rheingoldheavy/MSGEQ7-Breakout-Board/MSGEQ7_Breakout_Board/MSGEQ7_Breakout_Board_BOM.xlsx

Sheet: MSGEQ7 Breakout Board BOM
Index | Module | Item | Item Type | Distributor | Manufacturer | Manuf Part # | Distributor Part # | 1x Price | 10x Price | 25x Price | 100x Price | Datasheet | Manuf. Footprint | KiCAD Footprint | Size / Pinout
1 | Breakout Board | Bypass Capacitor 0.1uF | Capacitor | Digi-Key | Murata | RDER71H104K0M1H03A | 490-9144-1-ND | $0.2800 | $0.2360 | $0.2360 | $0.1180 | Link (http://media.digikey.com/pdf/Data%20Sheets/Murata%20PDFs/RDE%20Series.pdf) | PTH 5.0mm Spacing | C2 | x / x
2 | Breakout Board | Load Capacitor 33pF | Capacitor | Digi-Key | Vishay | K330J15C0GF5TL2 | BC1007CT-ND | $0.3400 | $0.2520 | $0.2520 | $0.1176 | Link (http://datasheet.octopart.com/K330J15C0GF5TL2-Vishay-datasheet-13562638.pdf) | PTH 2.5mm Spacing | C1 | x / x
3 | Breakout Board | Timing Resistor 200K | Resistor | Digi-Key | Stackpole Electronics | CF14JT200K | CF14JT200KCT-ND | $0.1000 | $0.0530 | $0.0530 | $0.0219 | Link (https://www.seielect.com/catalog/SEI-CF_CFM.pdf) | PTH 6mm body / .55mm lead dia. | PTH_RESISTOR | x / x
4 | Breakout Board | Input Resistor 22K | Resistor | Digi-Key | Stackpole Electronics | CF14JT22K0 | CF14JT22K0CT-ND | $0.1000 | $0.0530 | $0.0530 | $0.0219 | Link (https://www.seielect.com/catalog/SEI-CF_CFM.pdf) | PTH 6mm body / .55mm lead dia. | PTH_RESISTOR | x / x
5 | Breakout Board | MSGEQ7 | Main IC | Mixed Signal Integration | Mixed Signal Integration | MSGEQ7P | MSGEQ7P | $3.9600 | $3.9600 | $3.9600 | $3.9600 | Link (http://www.mix-sig.com/index.php/msgeq7-seven-band-graphic-equalizer-display-filter) | DIP-8 | DIP-8_300 | x / x
6 | Breakout Board | Mechanical | 6 Pin Header | Digi-Key | Sullins Connector | PREC005SAAN-RC | S1012EC-05-ND | $0.1600 | $0.1460 | $0.1460 | $0.1202 | Link (http://media.digikey.com/PDF/Data%20Sheets/Sullins%20PDFs/z%20RzCzzzSzzN-RC,%20ST,11635-B.pdf) | 0.1" Spaced Header | PIN_ARRAY_5x1 | x / x
7 | Breakout Board | Audio In Jack | Stereo Mini Jack | Digi-Key | CUI Inc | SJ1-3523NG | CP1-3523NG-ND | $1.0400 | $0.8080 | $0.8080 | $0.6165 | Link (http://www.cui.com/product/resource/sj1-352xng-series.pdf) | 3-pin Custom | Custom | x / x
8 | Breakout Board | PCB Fabrication | PCB | OSH Park | OSH Park | N/A | N/A | $2.9300 | $2.9300 | $2.9300 | $1.2900

Sheet: Order Work Sheet
Index | Module | Item | Item Type | Distributor | Manufacturer | Manuf Part # | Qty / Assy | Assy | Ttl Min Qty | Order Qty | Distributor Part # | 1x Price | 10x Price | 25x Price | 100x Price | Order Price
1 | Breakout Board | Bypass Capacitor 0.1uF | Capacitor | Digi-Key | Murata | RDER71H104K0M1H03A | 3 | 1 | 3 | 3 | 490-9144-1-ND | $0.2800 | $0.2360 | $0.2360 | $0.1180 | $0.8400
2 | Breakout Board | Load Capacitor 33pF | Capacitor | Digi-Key | Vishay | K330J15C0GF5TL2 | 1 | 1 | 1 | 1 | BC1007CT-ND | $0.3400 | $0.2520 | $0.2520 | $0.1176 | $0.3400
3 | Breakout Board | Timing Resistor 200K | Resistor | Digi-Key | Stackpole Electronics | CF14JT200K | 1 | 1 | 1 | 1 | CF14JT200KCT-ND | $0.1000 | $0.0530 | $0.0530 | $0.0219 | $0.1000
4 | Breakout Board | Input Resistor 22K | Resistor | Digi-Key | Stackpole Electronics | CF14JT22K0 | 2 | 1 | 2 | 2 | CF14JT22K0CT-ND | $0.1000 | $0.0530 | $0.0530 | $0.0219 | $0.2000
5 | Breakout Board | MSGEQ7 | Main IC | Mixed Signal Integration | Mixed Signal Integration | MSGEQ7P | 1 | 1 | 1 | 1 | MSGEQ7P | $3.9600 | $3.9600 | $3.9600 | $3.9600 | $3.9600
6 | Breakout Board | Mechanical | 6 Pin Header | Digi-Key | Sullins Connector | PREC006SAAN-RC | 1 | 1 | 1 | 1 | S1012EC-06-ND | $0.1800 | $0.1570 | $0.1570 | $0.1296 | $0.1800
7 | Breakout Board | Audio In Jack | Stereo Mini Jack | Digi-Key | CUI Inc | SJ1-3523NG | 1 | 1 | 1 | 1 | CP1-3523NG-ND | $1.0400 | $0.8080 | $0.8080 | $0.6165 | $1.0400
 |  |  |  |  |  |  |  |  |  |  |  |  |  |  | Total Parts Cost: | $6.66
 |  |  |  |  |  |  |  |  |  |  |  |  |  |  | Parts Cost Per Board: | $6.66
