rheingoldheavy/MSGEQ7-Breakout-Board/MSGEQ7_Breakout_Board/MSGEQ7_Breakout_Board.pdf

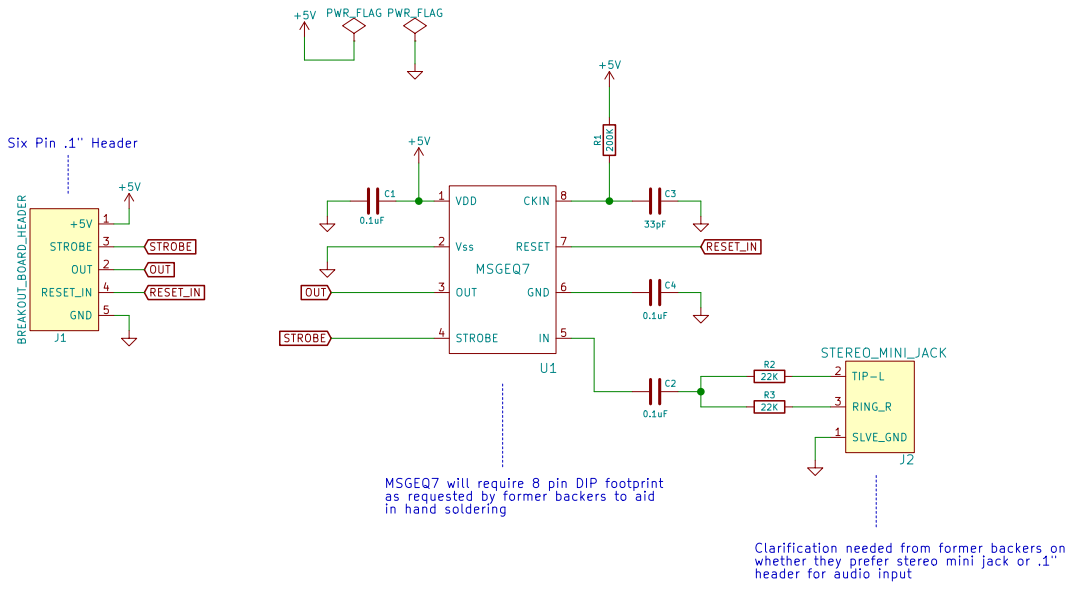
[picture p1: page 1]

MSGEQ7 will require 8 pin DIP footprint
as requested by former backers to aid
in hand soldering

Clarification needed from former backers on
whether they prefer stereo mini jack or .1"
header for audio input

Update to KiCad v4.0.0_RC1
Breakout board for the Mixed Signals Integration MSGEQ7
File: MSGEQ7_Breakout_Board.sch Sheet: / Rheingold Heavy

Id: 1/1 Title: MSGEQ7 Breakout Board
