rheingoldheavy/MSGEQ7-Breakout-Board/MSGEQ7_Breakout_Board/MSGEQ7_Breakout_Board.kicad_pcb

## KiCad design MSGEQ7_Breakout_Board/MSGEQ7_Breakout_Board.kicad_pcb (2015-10-28)

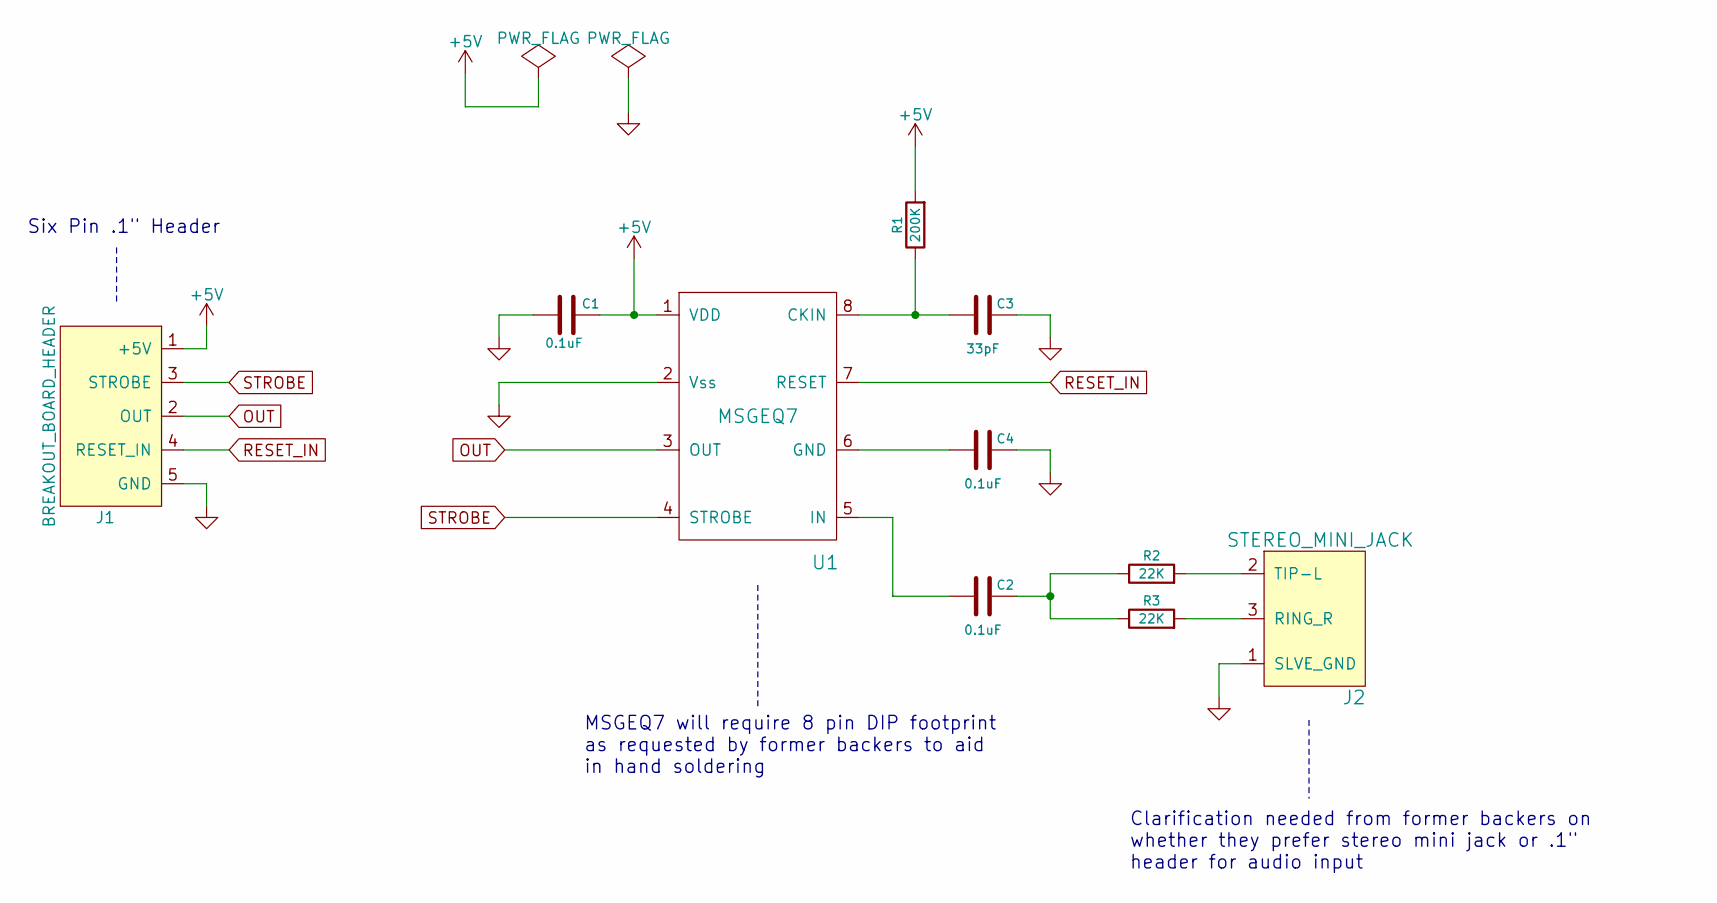
[picture p2: schematic MSGEQ7_Breakout_Board.sch, MSGEQ7 Breakout Board]

Parts:
C1, C2, C4: 0.1uF; C_Disc_D6_P5
C3: 33pF; C_Disc_D3_P2.5
J1: BREAKOUT_BOARD_HEADER; Pin_Header_Straight_1x05
J2: STEREO_MINI_JACK; 3.5mm_Stereo_Jack_SJ1-3523NG; MFG Part Num SJ1-3523NG
R1: 200K; PTH_Resistor
R2, R3: 22K; PTH_Resistor
U1: MSGEQ7; DIP-8_W7.62mm_LongPads

Connections:
+5V: C1.2, J1.1 (+5V), R1.2, U1.1 (VDD)
GND: C1.1, C3.2, C4.2, J1.5 (GND), J2.1 (SLVE_GND), U1.2 (Vss)
unnamed: C2.1, R2.1, R3.1
unnamed: C2.2, U1.5 (IN)
unnamed: C3.1, R1.1, U1.8 (CKIN)
unnamed: C4.1, U1.6 (GND)
unnamed: J2.2 (TIP-L), R2.2
unnamed: J2.3 (RING_R), R3.2
OUT: J1.2 (OUT), U1.3 (OUT)
RESET_IN: J1.4 (RESET_IN), U1.7 (RESET)
STROBE: J1.3 (STROBE), U1.4 (STROBE)

Notes on the sheet:
Six Pin .1" Header
MSGEQ7 will require 8 pin DIP footprint as requested by former backers to aid in hand soldering
Clarification needed from former backers on whether they prefer stereo mini jack or .1" header for audio input

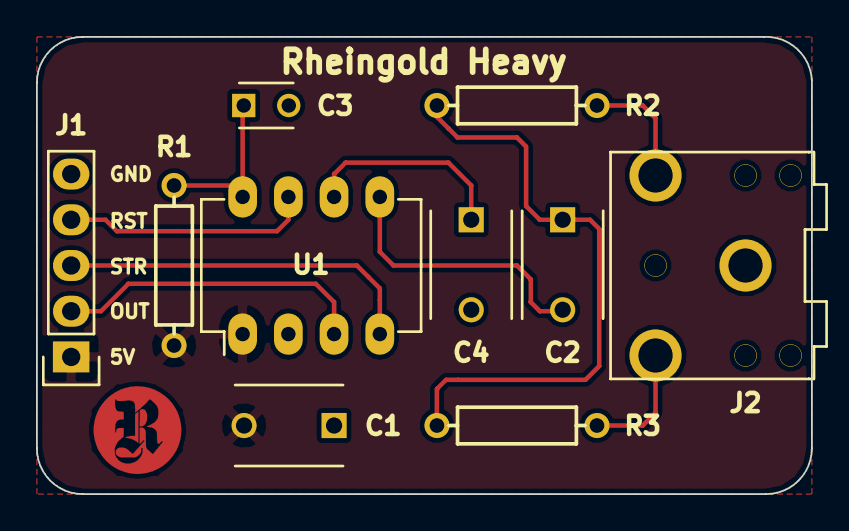
[picture p3: board MSGEQ7_Breakout_Board.kicad_pcb from above]

Board: 2 copper layers, 43.1 x 25.4 mm, 13 parts (0 on the bottom side), 11 nets.

Other parts of the board:
VAL: REF; Logo_RH_Circle_R__F.Cu_.2in
VAL#2: REF; Logo_RH_Circle_R__F.Mask_.2in
VAL#3: REF; Logo_RH_Circle_R_B.SilkS_.750in_flipped
