rheingoldheavy/MSGEQ7-Breakout-Board/(commit log)

2014-11-08 First Draft of Schematic
    First draft of the MSGEQ7 Breakout Board Schematic, based on the
    "Typical Application" drawing on page 4 of the Mixed Signal Integration
    MSGEQ7 Datasheet.
    http://www.mix-sig.com/images/datasheets/MSGEQ7.pdf
    [MSGEQ7_Breakout_Board.sch]
2014-11-15 Refined Schematic and BOM
    Refined the schematic to include new connectors and added the first
    draft of a BOM based on Octopart search.
    [MSGEQ7_Breakout_Board_BOM.xlsx]
2015-01-06 Prototype Layout Completed
    Submitted schematic to Mixed Signal Integration and had it validated for
    correctness. Finalized BOM for the prototype and completed layout with
    an eye towards producing as a kit: all PTH components, minimum .15"
    spacing.
    [MSGEQ7_Breakout_Board.kicad_pcb, MSGEQ7_Breakout_Board.sch, MSGEQ7_Breakout_Board_BOM.xlsx]
2015-01-07 First Gerbers Generated...
    The gerbers check out fine in GERBV, however they are incompatible with
    OSHParks service. There are two drill files (PTH and Non-PTH) whereas
    OSHPark expects only one. Additionally, the oval drills for the 3.5mm
    stereo jack pins is not registering as oval but circular which would not
    allow the component to mount successfully. This will need to be
    rectified with OSHPark Support tomorrow.
    [MSGEQ7_Breakout_Board-B_Cu.gbl, MSGEQ7_Breakout_Board-B_Mask.gbs, MSGEQ7_Breakout_Board-B_SilkS.gbo, MSGEQ7_Breakout_Board-Edge_Cuts.gbr, MSGEQ7_Breakout_Board-F_Cu.gtl, MSGEQ7_Breakout_Board-F_Mask.gts, MSGEQ7_Breakout_Board-F_SilkS.gto, MSGEQ7_Breakout_Board-NPTH.drl]
2015-01-07 Gerbers and Schematic Completed for Prototype
    The layout was modified to accomodate non-oval drills and drill files
    were merged. All manufacturers, part numbers and datasheet fields have
    been completed in the schematic.
    [MSGEQ7_Breakout_Board-B_Cu.gbl, MSGEQ7_Breakout_Board-B_Mask.gbs, MSGEQ7_Breakout_Board-B_SilkS.gbo, MSGEQ7_Breakout_Board-Edge_Cuts.gbr, MSGEQ7_Breakout_Board-F_Cu.gtl, MSGEQ7_Breakout_Board-F_Mask.gts, MSGEQ7_Breakout_Board-F_SilkS.gto, MSGEQ7_Breakout_Board-Merge.drl]
2015-01-30 Final Prototype Design
    Contains finalized prototype BOM, and all footprints including errors:
    pin drills too small for header and stereo jack not close enough to edge
    to accommodate face overhang. The next commit will be the production
    commit.
    [MSGEQ7_Breakout_Board-B_Cu.gbl, MSGEQ7_Breakout_Board-B_Mask.gbs, MSGEQ7_Breakout_Board-B_SilkS.gbo, MSGEQ7_Breakout_Board-Edge_Cuts.gbr, MSGEQ7_Breakout_Board-F_Cu.gtl, MSGEQ7_Breakout_Board-F_Mask.gts, MSGEQ7_Breakout_Board-F_SilkS.gto, MSGEQ7_Breakout_Board-Merge.drl]
2015-10-28 All Design Files Updated to KiCad v4.0.0_RC1
    [MSGEQ7_Breakout_Board-B_Cu.gbl, MSGEQ7_Breakout_Board-B_Mask.gbs, MSGEQ7_Breakout_Board-B_SilkS.gbo, MSGEQ7_Breakout_Board-Edge_Cuts.gbr, MSGEQ7_Breakout_Board-Edge_Cuts.gm1, MSGEQ7_Breakout_Board-F_Cu.gtl, MSGEQ7_Breakout_Board-F_Mask.gts, MSGEQ7_Breakout_Board-F_SilkS.gto]
